henrylyh3/arduino-remote-controller/aircond-controller-ui.png

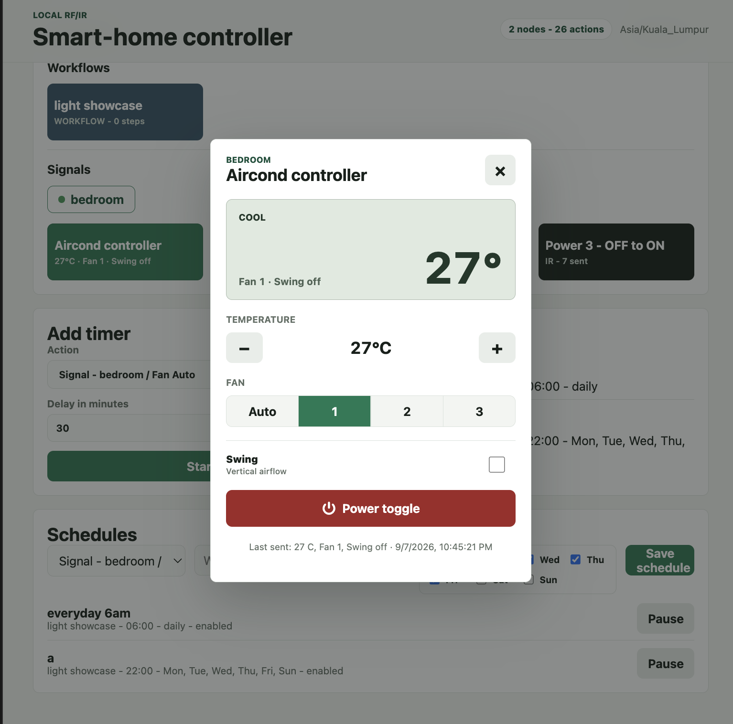
aircond-controller-ui.png
