henrylyh3/arduino-remote-controller/final-room-node-layout.png

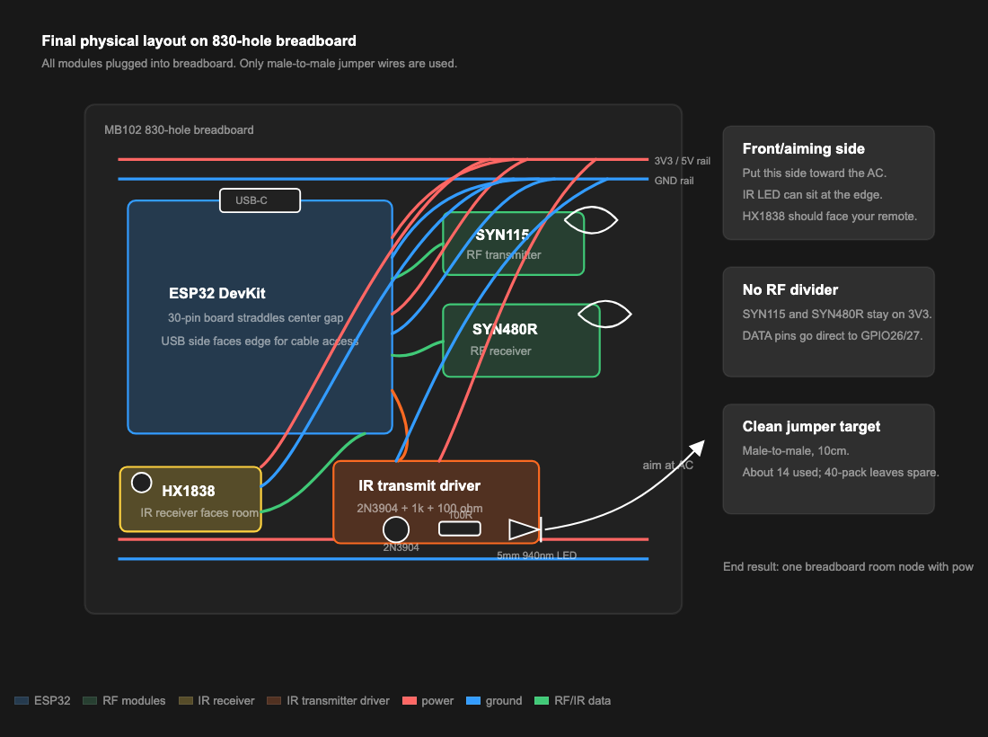
final-room-node-layout.png
