henrylyh3/arduino-remote-controller/backend/requirements-build.txt

-r requirements.txt
pyinstaller==6.22.2
pywebview==6.2.1
tzdata==2026.3
