henrylyh3/arduino-remote-controller/firmware/esp32_room_node/esp32_room_node.ino

#include <Arduino.h>
#include <Preferences.h>
#include <WiFi.h>
#include <WebServer.h>
#include <esp32-hal-rmt.h>
#include <vector>

#include <RCSwitch.h>
#include <IRremoteESP8266.h>
#include <IRrecv.h>
#include <IRsend.h>
#include <IRutils.h>

const uint8_t RF_TX_PIN = 26;
const uint8_t RF_RX_PIN = 27;
const uint8_t IR_TX_PIN = 4;
const uint8_t IR_RX_PIN = 14;
const unsigned long WIFI_RECONNECT_INTERVAL_MS = 5000;
const uint8_t CONFIG_RESET_PIN = 0;
const uint32_t RF_RMT_FREQUENCY_HZ = 1000000;
const uint16_t RF_RMT_IDLE_US = 20000;
const uint8_t RF_RMT_FILTER_US = 1;
const size_t RF_RMT_CAPTURE_SYMBOLS =
    RMT_MEM_NUM_BLOCKS_4 * RMT_SYMBOLS_PER_CHANNEL_BLOCK;

const uint16_t IR_CAPTURE_BUFFER = 1024;
const uint8_t IR_TIMEOUT_MS = 50;
const char *DEFAULT_NODE_NAME = "esp32-room-node";
const char *SETUP_AP_SSID = "rf-ir-node-setup";

WebServer server(80);
Preferences prefs;
RCSwitch rfTx = RCSwitch();
RCSwitch rfRx = RCSwitch();
IRsend irsend(IR_TX_PIN);
IRrecv irrecv(IR_RX_PIN, IR_CAPTURE_BUFFER, IR_TIMEOUT_MS, true);
decode_results irResults;
String wifiSsid;
String wifiPassword;
String nodeName = DEFAULT_NODE_NAME;
bool setupMode = false;
unsigned long lastWifiReconnectAttempt = 0;

String jsonEscape(const String &value) {
  String escaped;
  escaped.reserve(value.length() + 4);
  for (size_t i = 0; i < value.length(); i++) {
    char c = value[i];
    if (c == '"' || c == '\\') {
      escaped += '\\';
      escaped += c;
    } else if (c == '\n') {
      escaped += "\\n";
    } else if (c == '\r') {
      escaped += "\\r";
    } else {
      escaped += c;
    }
  }
  return escaped;
}

unsigned long argUL(const String &name, unsigned long fallback) {
  if (!server.hasArg(name)) return fallback;
  return strtoul(server.arg(name).c_str(), nullptr, 10);
}

void sendJson(int code, const String &body) {
  server.sendHeader("Connection", "close");
  server.send(code, "application/json", body);
}

void sendError(int code, const String &message) {
  sendJson(code, "{\"ok\":false,\"error\":\"" + jsonEscape(message) + "\"}");
}

bool parseRawCsv(const String &csv, std::vector<uint16_t> &out) {
  int start = 0;
  while (start < csv.length()) {
    int comma = csv.indexOf(',', start);
    if (comma < 0) comma = csv.length();
    String part = csv.substring(start, comma);
    part.trim();
    if (part.length() > 0) {
      long value = part.toInt();
      if (value <= 0 || value > 65535) return false;
      out.push_back(static_cast<uint16_t>(value));
    }
    start = comma + 1;
  }
  return out.size() > 0;
}

bool parseSignedRawCsv(const String &csv, std::vector<int32_t> &out) {
  int start = 0;
  while (start < csv.length()) {
    int comma = csv.indexOf(',', start);
    if (comma < 0) comma = csv.length();
    String part = csv.substring(start, comma);
    part.trim();
    if (part.length() > 0) {
      char *end = nullptr;
      long value = strtol(part.c_str(), &end, 10);
      if (*end != '\0' || value == 0 || value < -32767 || value > 32767) {
        return false;
      }
      out.push_back(static_cast<int32_t>(value));
    }
    start = comma + 1;
  }
  return !out.empty();
}

void handleHealth() {
  IPAddress ip = setupMode ? WiFi.softAPIP() : WiFi.localIP();
  String body = "{\"ok\":true,\"name\":\"";
  body += jsonEscape(nodeName);
  body += "\",\"ip\":\"";
  body += ip.toString();
  body += "\",\"setup_mode\":";
  body += setupMode ? "true" : "false";
  body += ",\"rf_tx\":26,\"rf_rx\":27,\"ir_tx\":4,\"ir_rx\":14}";
  sendJson(200, body);
}

void handleConfigPage() {
  String html = F(
      "<!doctype html><html><head><meta name='viewport' content='width=device-width,initial-scale=1'>"
      "<title>ESP32 RF/IR setup</title><style>"
      "body{font-family:system-ui;margin:0;background:#f4f6f3;color:#17201b}"
      "main{max-width:420px;margin:40px auto;padding:18px}"
      "form{display:grid;gap:12px;background:white;border:1px solid #dbe2dc;border-radius:8px;padding:18px}"
      "label{display:grid;gap:6px;font-size:13px;font-weight:700;color:#647067}"
      "input,button{font:inherit;min-height:42px;border-radius:8px}"
      "input{border:1px solid #dbe2dc;padding:0 10px}"
      "button{border:0;background:#0f7a54;color:white;font-weight:800}"
      "</style></head><body><main><h1>ESP32 RF/IR setup</h1>"
      "<form method='post' action='/save'>"
      "<label>Wi-Fi SSID<input name='ssid' required></label>"
      "<label>Wi-Fi password<input name='password' type='password'></label>"
      "<label>Node name<input name='name' value='esp32-room-node'></label>"
      "<button type='submit'>Save and reboot</button>"
      "</form></main></body></html>");
  server.send(200, "text/html", html);
}

void handleSaveConfig() {
  if (!server.hasArg("ssid")) {
    server.send(400, "text/plain", "missing ssid");
    return;
  }

  String savedName = server.arg("name");
  savedName.trim();
  if (savedName.length() == 0) savedName = DEFAULT_NODE_NAME;

  prefs.begin("controller", false);
  prefs.putString("ssid", server.arg("ssid"));
  prefs.putString("password", server.arg("password"));
  prefs.putString("name", savedName);
  prefs.end();

  server.send(200, "text/html", "<p>Saved. Rebooting.</p>");
  delay(800);
  ESP.restart();
}

void handleSendRF() {
  if (!server.hasArg("code") || !server.hasArg("bits")) {
    sendError(400, "missing code or bits");
    return;
  }

  unsigned long code = argUL("code", 0);
  int bits = static_cast<int>(argUL("bits", 24));
  int protocol = static_cast<int>(argUL("protocol", 1));
  int pulseLength = static_cast<int>(argUL("pulse_length", 0));
  int repeat = static_cast<int>(argUL("repeat", 6));

  rfTx.setProtocol(protocol);
  if (pulseLength > 0) rfTx.setPulseLength(pulseLength);
  rfTx.setRepeatTransmit(repeat);
  rfTx.send(code, bits);

  String body = "{\"ok\":true,\"signal_type\":\"rf\",\"code\":";
  body += String(code);
  body += ",\"bits\":";
  body += String(bits);
  body += "}";
  sendJson(200, body);
}

void handleSendRFRaw() {
  String body = server.arg("plain");
  if (body.length() == 0) {
    sendError(400, "missing raw body");
    return;
  }

  std::vector<uint16_t> raw;
  if (!parseRawCsv(body, raw) || raw.size() < 3) {
    sendError(400, "raw body must contain comma-separated positive microseconds");
    return;
  }

  int repeat = static_cast<int>(argUL("repeat", 6));
  uint16_t syncHigh = static_cast<uint16_t>(argUL("sync_high", 0));
  if (repeat < 1 || repeat > 50 || syncHigh == 0) {
    sendError(400, "repeat must be 1-50 and sync_high is required");
    return;
  }

  rfRx.disableReceive();
  digitalWrite(RF_TX_PIN, LOW);
  delayMicroseconds(raw[0]);
  for (int sent = 0; sent < repeat; sent++) {
    for (size_t i = 1; i < raw.size(); i++) {
      digitalWrite(RF_TX_PIN, (i % 2 == 1) ? HIGH : LOW);
      delayMicroseconds(raw[i]);
    }
    digitalWrite(RF_TX_PIN, HIGH);
    delayMicroseconds(syncHigh);
    digitalWrite(RF_TX_PIN, LOW);
    if (sent + 1 < repeat) delayMicroseconds(raw[0]);
  }
  digitalWrite(RF_TX_PIN, LOW);
  rfRx.enableReceive(digitalPinToInterrupt(RF_RX_PIN));

  String response = "{\"ok\":true,\"signal_type\":\"rf_raw\",\"count\":";
  response += String(raw.size());
  response += ",\"repeat\":";
  response += String(repeat);
  response += "}";
  sendJson(200, response);
}

void handleSendRFBurst() {
  String body = server.arg("plain");
  if (body.length() == 0) {
    sendError(400, "missing burst body");
    return;
  }

  std::vector<int32_t> pulses;
  if (!parseSignedRawCsv(body, pulses) || pulses.size() < 4 ||
      pulses.size() > RF_RMT_CAPTURE_SYMBOLS * 2) {
    sendError(400, "burst must contain 4-512 signed microsecond durations");
    return;
  }

  std::vector<rmt_data_t> symbols((pulses.size() + 1) / 2);
  for (size_t i = 0; i < symbols.size(); i++) {
    size_t first = i * 2;
    symbols[i].level0 = pulses[first] > 0 ? HIGH : LOW;
    symbols[i].duration0 = abs(pulses[first]);
    if (first + 1 < pulses.size()) {
      symbols[i].level1 = pulses[first + 1] > 0 ? HIGH : LOW;
      symbols[i].duration1 = abs(pulses[first + 1]);
    } else {
      symbols[i].level1 = LOW;
      symbols[i].duration1 = 0;
    }
  }

  rfRx.disableReceive();
  if (!rmtInit(RF_TX_PIN, RMT_TX_MODE, RMT_MEM_NUM_BLOCKS_1,
               RF_RMT_FREQUENCY_HZ)) {
    rfRx.enableReceive(digitalPinToInterrupt(RF_RX_PIN));
    sendError(500, "could not initialize RF burst transmitter");
    return;
  }
  rmtSetEOT(RF_TX_PIN, LOW);
  bool sent = rmtWrite(RF_TX_PIN, symbols.data(), symbols.size(), 5000);
  rmtDeinit(RF_TX_PIN);
  rfTx.enableTransmit(RF_TX_PIN);
  digitalWrite(RF_TX_PIN, LOW);
  rfRx.enableReceive(digitalPinToInterrupt(RF_RX_PIN));

  if (!sent) {
    sendError(500, "RF burst transmission failed");
    return;
  }

  String response = "{\"ok\":true,\"signal_type\":\"rf_burst\",\"pulse_count\":";
  response += String(pulses.size());
  response += "}";
  sendJson(200, response);
}

void handleSendIRRaw() {
  String body = server.arg("plain");
  if (body.length() == 0) {
    sendError(400, "missing raw body");
    return;
  }

  std::vector<uint16_t> raw;
  if (!parseRawCsv(body, raw)) {
    sendError(400, "raw body must be comma-separated positive microseconds");
    return;
  }

  uint16_t khz = static_cast<uint16_t>(argUL("khz", 38));
  int repeat = static_cast<int>(argUL("repeat", 1));
  for (int i = 0; i < repeat; i++) {
    irsend.sendRaw(raw.data(), raw.size(), khz);
    delay(50);
  }

  String response = "{\"ok\":true,\"signal_type\":\"ir\",\"count\":";
  response += String(raw.size());
  response += ",\"khz\":";
  response += String(khz);
  response += "}";
  sendJson(200, response);
}

void handleCaptureRF() {
  unsigned long timeoutMs = argUL("timeout_ms", 8000);
  unsigned long started = millis();
  rfRx.resetAvailable();

  while (millis() - started < timeoutMs) {
    if (!server.client().connected()) {
      rfRx.resetAvailable();
      return;
    }
    if (rfRx.available()) {
      unsigned long code = rfRx.getReceivedValue();
      unsigned int bits = rfRx.getReceivedBitlength();
      unsigned int protocol = rfRx.getReceivedProtocol();
      unsigned int pulseLength = rfRx.getReceivedDelay();
      rfRx.resetAvailable();

      if (code == 0) {
        sendError(422, "unknown rf encoding");
        return;
      }

      String body = "{\"signal_type\":\"rf\",\"code\":";
      body += String(code);
      body += ",\"bits\":";
      body += String(bits);
      body += ",\"protocol\":";
      body += String(protocol);
      body += ",\"pulse_length\":";
      body += String(pulseLength);
      body += ",\"repeat\":6}";
      sendJson(200, body);
      return;
    }
    delay(5);
  }

  sendError(408, "rf capture timeout");
}

void handleCaptureRFRaw() {
  unsigned long timeoutMs = argUL("timeout_ms", 15000);
  unsigned long started = millis();
  rfRx.resetAvailable();

  while (millis() - started < timeoutMs) {
    if (!server.client().connected()) {
      rfRx.resetAvailable();
      return;
    }
    if (rfRx.available()) {
      unsigned long code = rfRx.getReceivedValue();
      unsigned int bits = rfRx.getReceivedBitlength();
      unsigned int protocol = rfRx.getReceivedProtocol();
      unsigned int pulseLength = rfRx.getReceivedDelay();
      unsigned int rawCount = min(bits * 2 + 1, static_cast<unsigned int>(RCSWITCH_MAX_CHANGES));
      unsigned int *captured = rfRx.getReceivedRawdata();
      std::vector<uint16_t> raw(captured, captured + rawCount);
      rfRx.resetAvailable();

      if (code == 0) {
        sendError(422, "unknown rf encoding");
        return;
      }

      unsigned long shortPulseTotal = 0;
      unsigned int shortPulseCount = 0;
      for (size_t i = 1; i + 1 < raw.size(); i += 2) {
        shortPulseTotal += min(raw[i], raw[i + 1]);
        shortPulseCount++;
      }
      unsigned int rawBasePulse = shortPulseCount > 0
                                      ? shortPulseTotal / shortPulseCount
                                      : pulseLength;

      String body = "{\"signal_type\":\"rf_raw\",\"code\":";
      body += String(code);
      body += ",\"bits\":";
      body += String(bits);
      body += ",\"protocol\":";
      body += String(protocol);
      body += ",\"pulse_length\":";
      body += String(pulseLength);
      body += ",\"raw_base_pulse\":";
      body += String(rawBasePulse);
      body += ",\"sync_high\":";
      body += String(rawBasePulse);
      body += ",\"raw\":[";
      for (size_t i = 0; i < raw.size(); i++) {
        if (i > 0) body += ',';
        body += String(raw[i]);
      }
      body += "]}";
      sendJson(200, body);
      return;
    }
    delay(5);
  }

  sendError(408, "rf raw capture timeout");
}

bool appendCompleteRFFrames(const std::vector<int32_t> &captured,
                            unsigned int bits,
                            std::vector<int32_t> &frames,
                            unsigned int &frameCount) {
  const size_t framePulseCount = bits * 2 + 2;
  if (framePulseCount < 4 || captured.size() < framePulseCount) return false;

  for (size_t gap = framePulseCount - 1; gap < captured.size(); gap++) {
    long gapDuration = abs(captured[gap]);
    if (gapDuration < 4000 || gapDuration > 15000) continue;

    size_t start = gap - (framePulseCount - 1);
    bool valid = true;
    for (size_t i = start; i < gap; i++) {
      long duration = abs(captured[i]);
      if (duration < 250 || duration > 1800) {
        valid = false;
        break;
      }
      if (i > start && ((captured[i] > 0) == (captured[i - 1] > 0))) {
        valid = false;
        break;
      }
    }
    if (!valid || ((captured[gap] > 0) == (captured[gap - 1] > 0))) continue;

    frames.insert(frames.end(), captured.begin() + start, captured.begin() + gap + 1);
    frameCount++;
  }
  return frameCount > 0;
}

void handleCaptureRFBurst() {
  unsigned long timeoutMs = argUL("timeout_ms", 20000);
  unsigned long started = millis();
  unsigned long triggerCode = 0;
  unsigned int triggerBits = 0;
  unsigned int triggerProtocol = 0;
  rfRx.resetAvailable();

  while (millis() - started < timeoutMs) {
    if (!server.client().connected()) {
      rfRx.resetAvailable();
      return;
    }
    if (rfRx.available()) {
      triggerCode = rfRx.getReceivedValue();
      triggerBits = rfRx.getReceivedBitlength();
      triggerProtocol = rfRx.getReceivedProtocol();
      rfRx.resetAvailable();
      break;
    }
    delay(2);
  }

  if (triggerCode == 0 || triggerBits == 0) {
    sendError(408, "rf burst trigger timeout");
    return;
  }

  rfRx.disableReceive();

  if (!rmtInit(RF_RX_PIN, RMT_RX_MODE, RMT_MEM_NUM_BLOCKS_4,
               RF_RMT_FREQUENCY_HZ)) {
    rfRx.enableReceive(digitalPinToInterrupt(RF_RX_PIN));
    sendError(500, "could not initialize RF burst receiver");
    return;
  }
  rmtSetRxMinThreshold(RF_RX_PIN, RF_RMT_FILTER_US);
  rmtSetRxMaxThreshold(RF_RX_PIN, RF_RMT_IDLE_US);

  static rmt_data_t captured[RF_RMT_CAPTURE_SYMBOLS];
  std::vector<int32_t> frames;
  unsigned int frameCount = 0;
  bool capturedAny = false;

  while (millis() - started < timeoutMs && frameCount == 0) {
    size_t symbolCount = RF_RMT_CAPTURE_SYMBOLS;
    uint32_t remainingMs = timeoutMs - (millis() - started);
    bool readCompleted = rmtRead(RF_RX_PIN, captured, &symbolCount, remainingMs);
    if (!readCompleted && !rmtReceiveCompleted(RF_RX_PIN)) break;
    if (symbolCount == 0) continue;

    capturedAny = true;
    std::vector<int32_t> allPulses;
    allPulses.reserve(symbolCount * 2);
    for (size_t i = 0; i < symbolCount; i++) {
      if (captured[i].duration0 > 0) {
        int32_t duration = captured[i].duration0;
        allPulses.push_back(captured[i].level0 == LOW ? -duration : duration);
      }
      if (captured[i].duration1 > 0) {
        int32_t duration = captured[i].duration1;
        allPulses.push_back(captured[i].level1 == LOW ? -duration : duration);
      }
    }
    appendCompleteRFFrames(allPulses, triggerBits, frames, frameCount);
  }

  rmtDeinit(RF_RX_PIN);
  rfRx.enableReceive(digitalPinToInterrupt(RF_RX_PIN));

  if (!capturedAny) {
    sendError(408, "rf burst follow-up timeout; release and press the same button again");
    return;
  }

  if (frameCount == 0) {
    sendError(422, "RF detected but no complete frame captured; press, release, then press the same button again");
    return;
  }

  String body = "{\"signal_type\":\"rf_burst\",\"tick_us\":1,\"trigger_code\":";
  body += String(triggerCode);
  body += ",\"bits\":";
  body += String(triggerBits);
  body += ",\"protocol\":";
  body += String(triggerProtocol);
  body += ",\"frames\":";
  body += String(frameCount);
  body += ",\"pulses\":[";
  for (size_t i = 0; i < frames.size(); i++) {
    if (i > 0) body += ',';
    body += String(frames[i]);
  }
  body += "],\"pulse_count\":";
  body += String(frames.size());
  body += "}";
  sendJson(200, body);
}

void handleCaptureIR() {
  unsigned long timeoutMs = argUL("timeout_ms", 10000);
  unsigned long started = millis();
  irrecv.resume();

  while (millis() - started < timeoutMs) {
    if (!server.client().connected()) {
      irrecv.resume();
      return;
    }
    if (irrecv.decode(&irResults)) {
      String body = "{\"signal_type\":\"ir\",\"raw\":[";
      for (uint16_t i = 1; i < irResults.rawlen; i++) {
        uint32_t duration = irResults.rawbuf[i] * kRawTick;
        if (i > 1) body += ",";
        body += String(duration);
      }
      body += "],\"khz\":38,\"repeat\":1}";
      irrecv.resume();
      sendJson(200, body);
      return;
    }
    delay(5);
  }

  sendError(408, "ir capture timeout");
}

void handleNotFound() {
  sendError(404, "not found");
}

void loadConfig() {
  pinMode(CONFIG_RESET_PIN, INPUT_PULLUP);
  bool resetConfig = digitalRead(CONFIG_RESET_PIN) == LOW;

  prefs.begin("controller", false);
  if (resetConfig) {
    prefs.clear();
  }
  wifiSsid = prefs.getString("ssid", "");
  wifiPassword = prefs.getString("password", "");
  nodeName = prefs.getString("name", DEFAULT_NODE_NAME);
  prefs.end();
}

bool connectWifi() {
  if (wifiSsid.length() == 0) return false;

  WiFi.mode(WIFI_STA);
  WiFi.setSleep(false);
  WiFi.setAutoReconnect(true);
  WiFi.begin(wifiSsid.c_str(), wifiPassword.c_str());
  Serial.print("WiFi");
  unsigned long started = millis();
  while (WiFi.status() != WL_CONNECTED && millis() - started < 30000) {
    delay(500);
    Serial.print(".");
  }
  Serial.println();
  if (WiFi.status() != WL_CONNECTED) {
    WiFi.disconnect(true);
    return false;
  }
  Serial.print("IP: ");
  Serial.println(WiFi.localIP());
  return true;
}

void registerApiRoutes() {
  server.on("/", HTTP_GET, handleHealth);
  server.on("/health", HTTP_GET, handleHealth);
  server.on("/send/rf", HTTP_GET, handleSendRF);
  server.on("/send/rf/raw", HTTP_POST, handleSendRFRaw);
  server.on("/send/rf/burst", HTTP_POST, handleSendRFBurst);
  server.on("/send/ir/raw", HTTP_POST, handleSendIRRaw);
  server.on("/capture/rf", HTTP_GET, handleCaptureRF);
  server.on("/capture/rf/raw", HTTP_GET, handleCaptureRFRaw);
  server.on("/capture/rf/burst", HTTP_GET, handleCaptureRFBurst);
  server.on("/capture/ir", HTTP_GET, handleCaptureIR);
  server.onNotFound(handleNotFound);
}

void registerSetupRoutes() {
  server.on("/", HTTP_GET, handleConfigPage);
  server.on("/save", HTTP_POST, handleSaveConfig);
  server.on("/health", HTTP_GET, handleHealth);
  server.onNotFound(handleNotFound);
}

void startSetupPortal() {
  setupMode = true;
  WiFi.mode(WIFI_AP);
  WiFi.softAP(SETUP_AP_SSID);
  registerSetupRoutes();
  server.begin();
  Serial.print("Setup AP: ");
  Serial.println(SETUP_AP_SSID);
  Serial.print("Setup URL: http://");
  Serial.println(WiFi.softAPIP());
}

void setup() {
  Serial.begin(115200);
  delay(200);

  loadConfig();

  if (!connectWifi()) {
    startSetupPortal();
    return;
  }

  rfTx.enableTransmit(RF_TX_PIN);
  rfRx.enableReceive(digitalPinToInterrupt(RF_RX_PIN));
  irsend.begin();
  irrecv.enableIRIn();

  registerApiRoutes();
  server.begin();

  Serial.println("HTTP server ready");
}

void loop() {
  if (!setupMode && WiFi.status() != WL_CONNECTED &&
      millis() - lastWifiReconnectAttempt >= WIFI_RECONNECT_INTERVAL_MS) {
    lastWifiReconnectAttempt = millis();
    Serial.println("WiFi disconnected; reconnecting");
    WiFi.reconnect();
  }
  server.handleClient();
}
